indulekha99/Orthotic-Lowerlimb-Exoskeleton/README.md

# Orthotic-Lowerlimb-Exoskeleton
A lower limb exoskeleton for children capable of aiding the physical therapy process
