indulekha99/Orthotic-Lowerlimb-Exoskeleton/Report.pdf

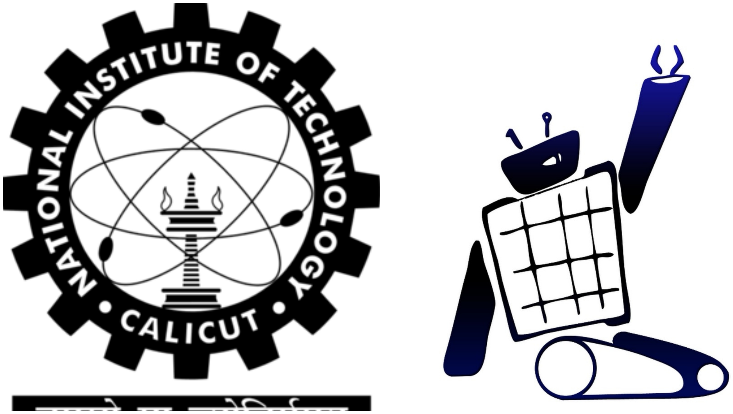
[picture p1: figure]

# REHABILITATION AND ASSISTIVE EXOSKELETON

## November 2021

## Contents

1 Introduction | 1
2 Gait Pattern | 2
3 Data Collection | 4
4 Mechanical Design | 7
5 Modelling | 13
6 Control | 20

## 1 Introduction

Exoskeletons are wearable robotic devices which are used for rehabilitation and for providing assistance in doing a task. It is powered by electric motors, pneumatics, hydraulics or combination of any of these to provide enhanced limb movement. Cerebral palsy is a neurological disorder that affects muscles of the patient and constrains him from doing any movements of his limbs easily. This motor neuron disease is a group of disorders that affect muscle movement and coordination. The best-known solution to this problem is physical therapy and regular walking practice. In the rehabilitation routine, the physiotherapist makes the patient perform certain gait cycles at varied speeds and distances. As repeating a task with negligible variation is a great challenge for humans, exoskeleton can be used to complete the task. This can also be used in places where strength is a key factor for work. It also empowers the military of the nation by making the job of the soldiers less tedious. Our aim is to build a lower limb exoskeleton for children capable of aiding the physical therapy process. Assistive exoskeletons are very expensive and cannot be purchased by a physiotherapy centre to provide treatment economically. With proper selection of actuators and other materials we can build it in a small budget.

## 2 Gait Pattern

A gait is a pattern of limb movements made during locomotion. Repetition of gait cycle leads to locomotion.

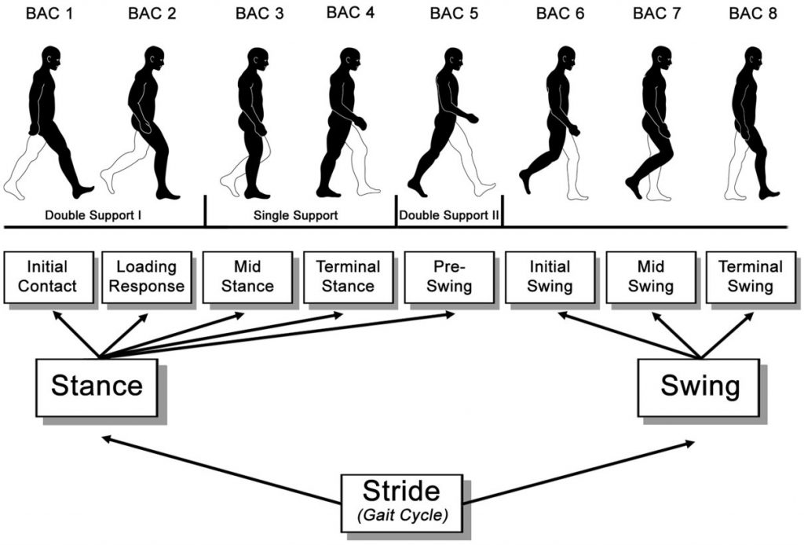
[picture p2: figure]

Figure 1: Gait Pattern

A complete gait cycle shown in the figure. For understanding we can define the gait cycle as the process between one foot striking the ground to the same foot again striking the ground. It is also known as one stride. The Gait cycle can be divided into two major phases:Stance phase, Swing phase

### 2.1 Stance phase

Stance phase is that part of a gait cycle during which the foot remains in contact with the ground. It constitutes almost 62
Initial Contact (Heel Strike): The heel of the reference foot touches the ground in front of the body.
Loading response : It begins immediately after the foot strike.During this phase body weight is transferred onto the supporting limb.
Mid-stance Phase: During mid-stance phase the reference foot contacts the ground flat-footed.
Terminal stance: Begins when the supporting heel rises from the ground and continues until the opposite heel touches the ground.
Pre-swing Phase: This phase corresponds to the loading response phase of the opposite foot.

### 2.2 Swing phase

Stance phase is that part of a gait cycle during which the reference foot is not in contact with the ground. It constitutes almost 38
Initial Swing Phase: The reference foot moves forward towards the opposite foot, while the knee and the hip are flexing.
Mid-swing Phase: Hip continues to flex, the reference foot pushes forward and gradually surpasses the supporting foot.
Terminal Swing Phase: During terminal swing phase, the reference foot begins landing to the ground as the respective knee and hip begin extension.

## 3 Data Collection

Lower limb rehabilitation assistive exoskeleton must have good human compatibility. Therefore the selection of actuators and links are the most essential parts of the design.Based on the torque provided by the actuator we need to choose it.Angular patterns can be obtained from a complete gait analysis of a healthy person.By which we can calculate torque acting on the joins. Gait analysis also provides foundation for the controlling part.
The human leg has 6 degrees of freedom (3DOF for hip, 1DOF for knee and 2DOF for ankle). The exoskeleton provides the actuation only in the sagittal plane there by restricting the degrees of freedom to 3. The orthotic lower limb device is an exoskeleton for hip and knee joints. Therefore, the data required for the analysis is the angular pattern of hip and knee joints. Different techniques used in the data acquisition process are
Use of Optical Rotary Encoders Use of IMUs (Inertial Measurement Units) Use of Imaging techniques

### 3.1 Optical Rotaty Encoder

An optical rotary encoder uses a reliable,defined pattern of light and dark to determine the position of the shaft and therefore the position of the link which is connected to the shaft. It converts the angular position or motion of a shaft or axle to analog or digital output signals.
In an optical rotary encoder there is a light source and sensor in between circular plates . It has continuous slots of equal width. The sensor has a phototransistor, resistor, and schmitt trigger. When light is passed through the slots phototransistor activates and it offers minimum(0) resistance, it is fed to the schmitt trigger and it produces low output and most of the voltage(5v) is dropped across the resistor. When light is blocked, the phototransistor will be in off stage and it offers maximum resistance.So nearly 5 v dropped across the phototransistor and nearly zero voltage dropped across the resistor. That 5 v fed to schmitt trigger and it gives maximum output. Square wave pattern is obtained.From this , number of pulses per unit time and corresponding angle of rotation can be calculated.
Encoder is placed at the hip and a link is connected to the shaft of the encoder then that link is attached to the thigh, from this encoder we can determine the angular pattern of the hip joint. Now another encoder is wielded to link whose other end is an encoder which is placed at the hip and a link is attached to the second encoder and that is attached to the shank, through this we can determine the angular pattern at the knee.

### 3.2 Inertial Measurement Unit

An Inertial Measurement Unit(IMU), is an electronic device that tracks rotational and translational movements. It is composed of 3 accelerometers, 3 gyroscopes, and depending on the heading requirement – 3 magnetometers.IMUs can measure a variety of factors, including speed, direction, acceleration, specific force, angular rate and magnetic fields surrounding the device (in the presence of a magnetometer).Each tool in an IMU is used to capture different data types: Accelerometer measures velocity and acceleration,Gyroscope measures rotation and rotational rate, Magnetometer establishes cardinal direction (directional heading)
Gyroscopes in general are devices that measure angular displacement ,angular velocity etc. Most gyroscopes only measure along a single sensitive axis.Therefore a combination of three orthogonally mounted gyroscopes is required to sense three dimensional angular motion.
This rotation about the spin axis is detected and information on this rotation is delivered to a motor or other device that applies torque in an opposite direction thereby canceling the precession and maintaining its orientation.
A plane portion is connected to the thigh and IMU is attached to it .The method of measuring angle is the same as that of encoder.

### 3.3 Imaging Techniques

With the development of photography and cinematography, it is possible to capture image sequences that reveal even minute details of human and animal locomotion. Three green colour circular stickers were attached. One is at the hip and the other is at knee and the other is at the ankle. By using image processing techniques in matlab we made everything black in the image except at the location of stickers. Now we have calculated the centroids of each sticker. By using those points in every frame we have calculated the angular pattern at the hip and knee.
Let ( X1, Y1) , ( X2, Y2) , ( X3, Y3) be the centroids of the markers at hip, knee and ankle joint respectively.
Tangent of the angular displacement of the thigh is given by

T an(θ) = Y2 − Y1
X2 − X1

(1)

So angular displacement of the thigh is

arctan

Y2 − Y1
X2 − X1

(2)

### 3.4 Data Obtained

The angular position of hip and knee joints are recorded using the above mentioned techniques as a function of time from a healthy human sample.The minimum and maximum torque for hip and knee joints are calculated.

Max value Min value

Angle in degrees | 14.57 | -18.12
Angle in radians | 0.25 | -0.31
Angular velocity | 1.4 | -2.53
Angular acceleration | 17.86 | -28.39

Table 1: Data of Hip from Image Processing

Max value Min value

Angle in degrees | 56.46 | -16.52
Angle in radians | 0.98 | 0.29
Angular velocity | 3.03 | -5.39
Angular acceleration | 64.37 | -56.28

Table 2: Data of Knee from Image Processing

Max value Min value

Angle in degrees | 22.85 | -8.56
Angle in radians | 0.4 | -0.15
Angular velocity | 2.7 | -1.3
Angular acceleration | 20 | -20

Table 3: Data of Hip from Encoder

Max value Min value

Angle in degrees | 11.5 | -68.5
Angle in radians | 0.2 | -1.2
Angular velocity | 6 | -10
Angular acceleration | 115 | -105

Table 4: Data of Knee from Encoder

Hip joint :
Maximum torque : 30Nm
Minimum torque in opposite direction: 25Nm Knee joint :
Maximum torque : 10Nm
Minimum torque in opposite direction : 7Nm
This data is used for the dynamic analysis of the human gait. By using methods like Lagrange and Newton-Euler formulation, the dynamic analysis of the gait is done to find the torque provided by the muscles for walking.The Newton-Euler formulation is derived by the direct interpretation of Newton’s Second Law of Motion, which describes dynamic systems in terms of force and momentum. In the Lagrangian formulation the system’s dynamic behavior is described in terms of work and energy using generalized coordinates.

## 4 Mechanical Design

The exoskeleton design consists of 10 degrees of freedom(DOF) out of which 4 are active and 6 are passive. The 4 active DOF s are 2 knee joints and 2 hip joints which are revolute joints about mediolateral axis( axis perpendicular to the sagittal plane) and are controlled by DC motors. One DOF for each ankle joint(about a mediolateral axis), one DOF for each hip about an axis parallel to the anterior-posterior axis( the axis perpendicular to the frontal plane) and 2 DOF at the back of the exoskeleton about an axis parallel to the anterior-posterior axis are the 6 passive DOFs.

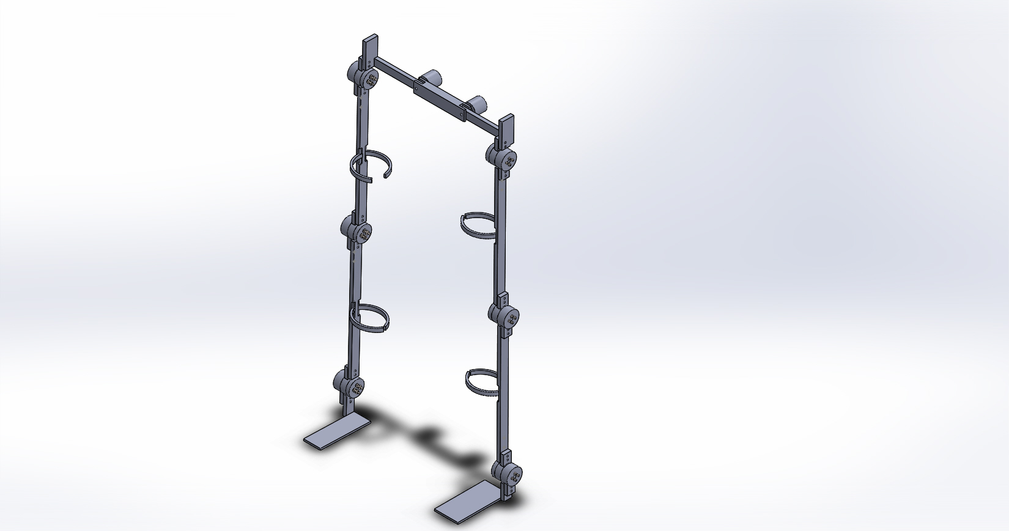
[picture p3: figure]

Figure 2: Lowerlimb Exoskeleton

Different Parts of the Design:-
1.There are 4 links that give structure to the exoskeleton and supports the human body. They are directly attached to the legs. Actuations are transmitted to the legs through these links
2.There are 4 joints through which the load is transmitted, out of which two joints are active and act as active joints. The joints should be able to transmit the load properly and at the same time, they should provide smooth movement to the limbs. Joint consist of 3 parts,
a) Middle Part This is the part that encloses a ball bearing and it connects to one of the links at the joint.
b) Outer Part The outer part connects to the adjacent link. It has a projection that goes halfway through the inner cylindrical portion of the ball bearing. The outer portion has a hole for the attachment of the motor shaft. In addition to this hole outer part have 4 holes for fastening with nuts and bolts.
c) Inner Part The Inner part is similar to the outer part except that it does not have a hole for motor shaft attachment.
Middle Part and Outer part fits inside the ball bearing from opposite sides and are fastened by 4 nuts and bolts. Middle Part connects the joint to one link and the Outer Part connects to the adjacent link. This type of arrangement ensures that

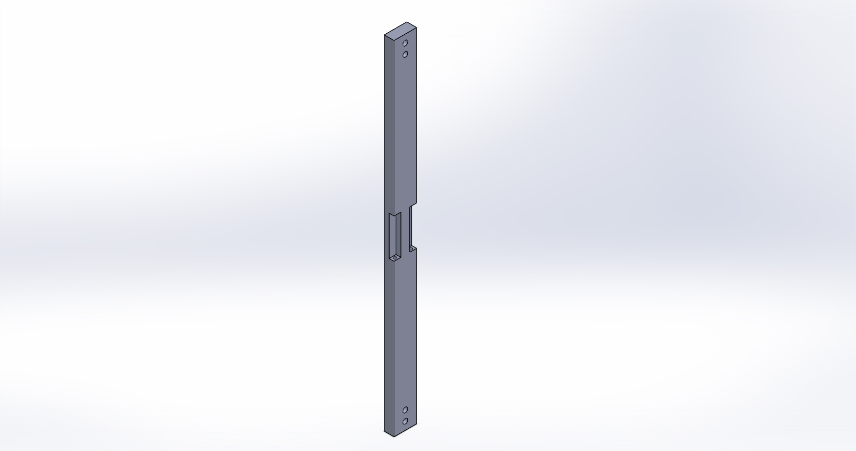
[picture p4: figure]

Figure 3: Link

the joint transmits the load without any failure and the relative movement between the links are smooth.
3.Hip Assembly Hip Assembly consists of 3 links and has two passive DOFs where two encoders are attached for data collection. Hip Assembly is directly attached to the body and is connected to the thigh link through 2 active joints and 2 passive joints.

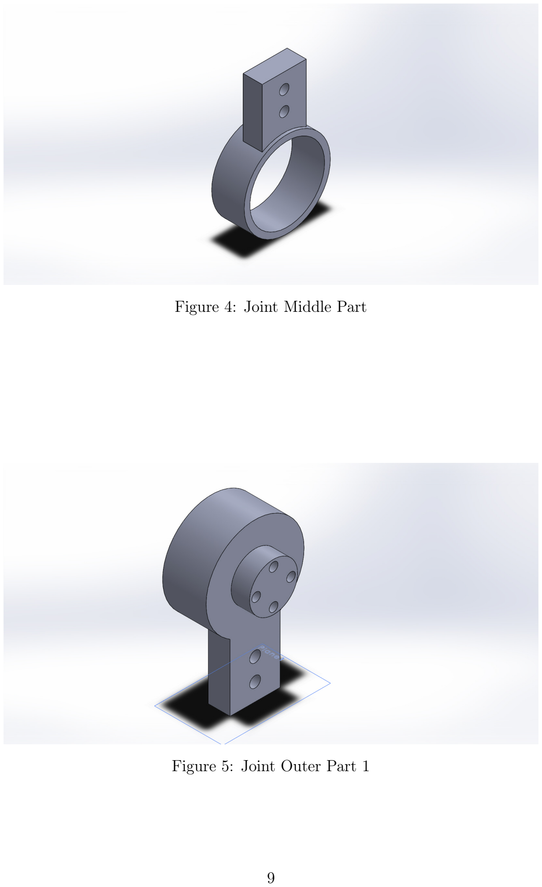
[picture p5: page 11]

Figure 4: Joint Middle Part

Figure 5: Joint Outer Part 1

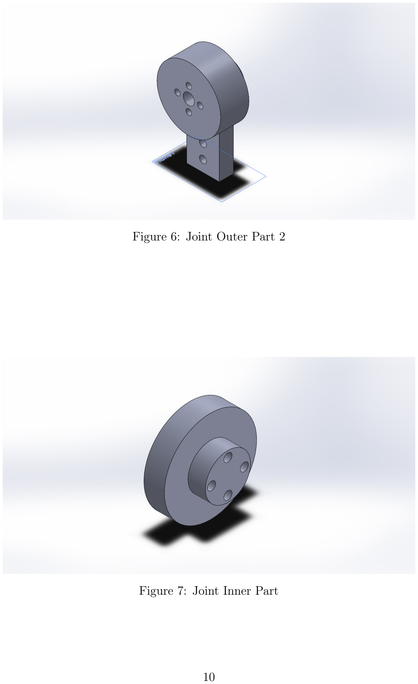
[picture p6: page 12]

Figure 6: Joint Outer Part 2

Figure 7: Joint Inner Part

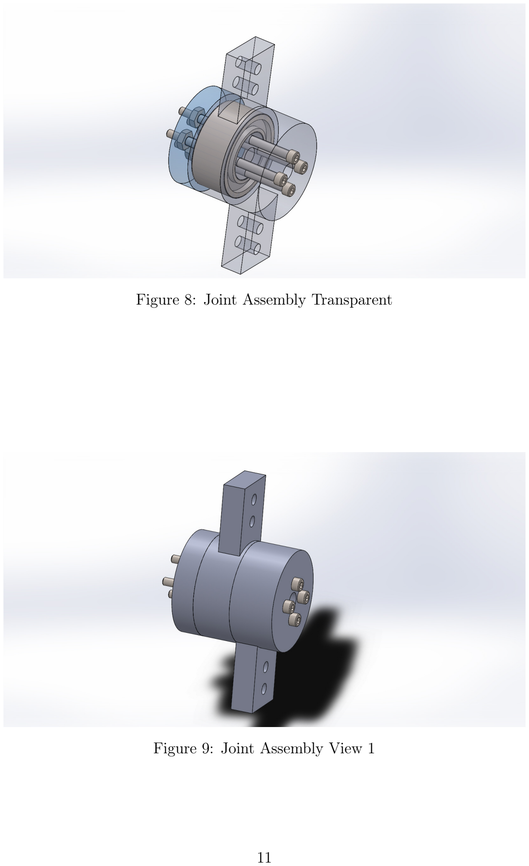
[picture p7: page 13]

Figure 8: Joint Assembly Transparent

Figure 9: Joint Assembly View 1

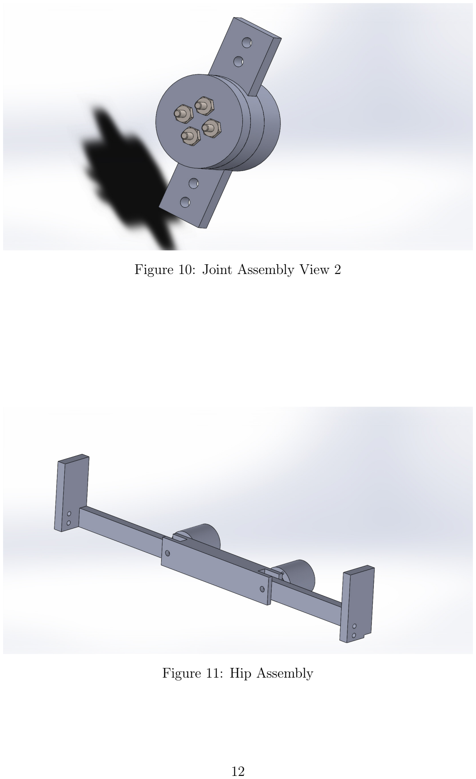
[picture p8: page 14]

Figure 10: Joint Assembly View 2

Figure 11: Hip Assembly

## 5 Modelling

### 5.1 Static Analysis

### 5.1.1 Forward kinematics

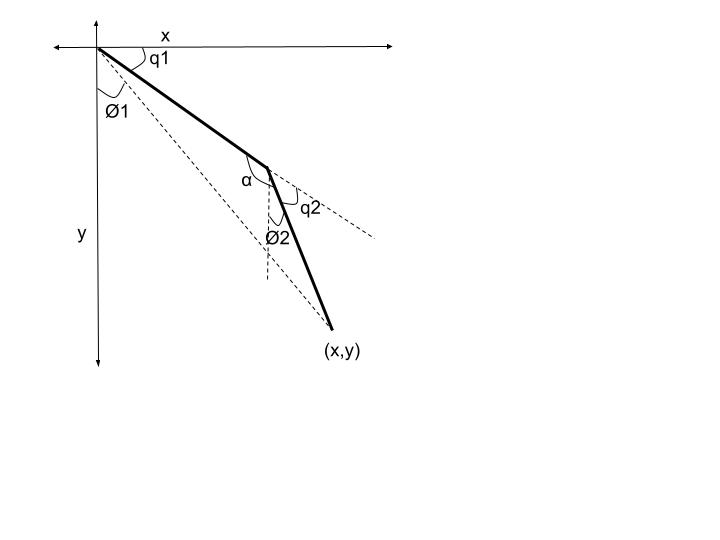
[picture p9: figure]

Figure 12: Forward Kinematics

We are dealing with the motion of the lower limb in the sagittal plane. Therefore constraining the motion in a 2D plane.
Length of link 1 = L1
Length of link 2 = L2
Angle made by link 1 = q1
Angle made by link 2 = q2
Task space, X = [x,y]
Joint/control space, q = [q1, q2]
End-effector:

X = F(θ) = [x, y] = [L1cos(q1) + L2cos(q1 + q2), L1sin(q1) + L2sin(q1 + q2)] (3)

### 5.1.2 Inverse kinematics

Consider the triangle AOB shown in the figure (13). AB = R = p
x

2 + y

2
Angle AOB = α
Apply cosine law We get

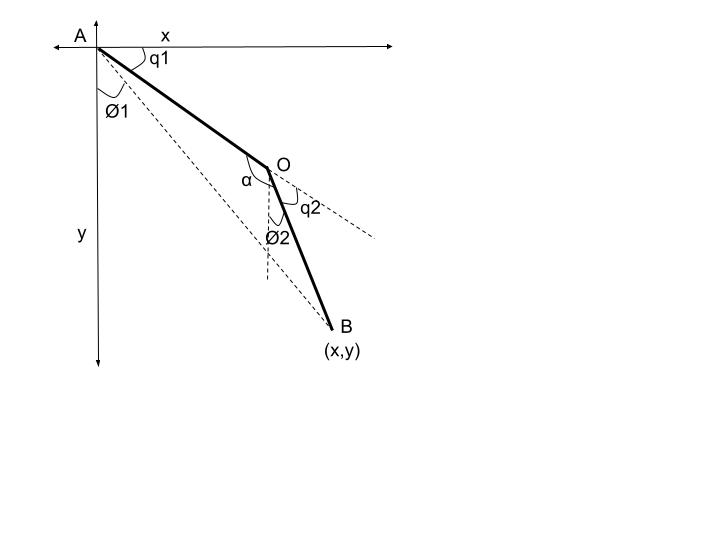
[picture p10: figure]

Figure 13: Inverse Kinematics

R

2 = L

2
1 + L

2
2 − 2L1L2cos(α) | (4)

cos(α) = L

2
1 + L

2

2 − X² − Y

2
2L1L2

(5)

q2 = π − α
cos(q2) = −cos(α)
cos(q2) = X² + Y

2 − L

2
1 − L

2
2
2L1L2

(6)

q2 = arccos

X² + Y

2 − L

2
1 − L

2
2
2L1L2

(7)

In triangle OBC in figure (14)

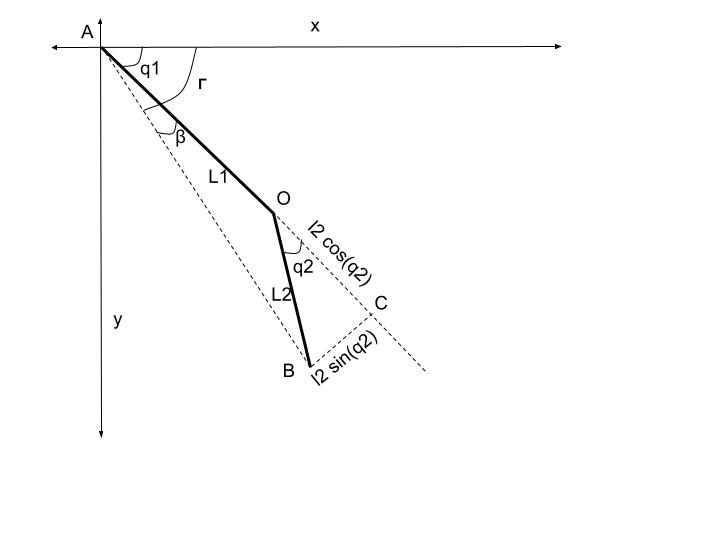
[picture p11: figure]

Figure 14: Inverse Kinematics

OC = L2cos(q2)
BC = L2sin(q2)
tan(β) = BC
AC
tan(β) = | L2sin(q2)
| L1 + L2cos(q2)

(8)

γ = q1 + β = arctan

y
x

(9)

q1 = arctan

| y
| x − arctan

L2sin(q2)
L1 + L2cos(q2)

(10)

From the equation 10 it is clear that q1 also depended on q2.
For a 2D two link manipulator there can be two solutions for q1 and q2. When we solve for q2
We get

cos(q2) = X

2 + Y

2 − L

2
1 −

L

2
2
2L1L2

(11)

w.k.t cos (q2) = cos(−q2)
So there is another pair of angles (q1, q2) which give the same end effector (x,y).

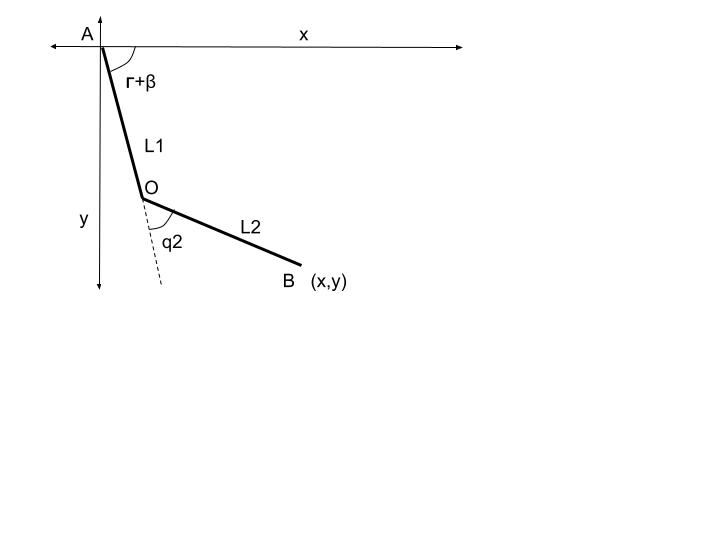
[picture p12: figure]

Figure 15: Inverse Kinematics

q2 = −X

2 + Y

2 − L

2
1 −

L

2
2
2L1L2

(12)

When we put -q2 in the equation 10

q1 = γ + β = arctan

y
x

+ arctan

L2sinq2
L1 + L2cos(q2)

(13)

But in our case this solution is not possible. Because the knee can only bend backwards.
We are dealing with hip ϕ1 and knee angle ϕ1 , that we can obtain from q2 and q2

ϕ1 = (π
2
− q1) | (14)
ϕ2 = (π
2
− (q1 + q2)) | (15)

### 5.2 Dynamic Analysis

Consider the 2 links of the exoskeleton as shown in figure (16). Masses of link 1 and 2 are m1 and m2 respectively. X axis is considered as the reference for gravitational potential energy(PE=0).

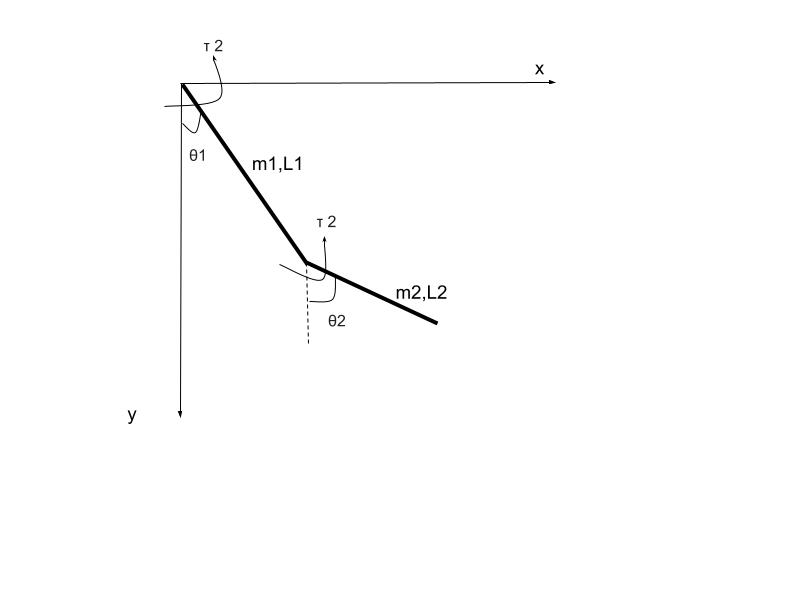
[picture p13: figure]

Figure 16: Dynamic Analysis

For Link 1, consider an element of length dl at a distance of l from the ori-gin,position and velocity of that element is

x1 = lsin(θ1) | (16)
y1 = lcos(θ1) | (17)

x˙1 = l

˙θ1cos(θ1) | (18)

y˙1 = −l

˙θ1sin(θ1) | (19)
| (20)

Now the kinetic energy can be expressed as ,

KE =

1
2

mv²

=

1
2

m( ˙x

2 + ˙y

2
) | (21)

The mass per unit length of link 1 is, is mi = m1/L1. Now the kinetic energy of the elemental mass of length dl is

dKEi =

1
2

(mi ∗ dl)( ˙x1

2 + ˙y1

2
)

=

1
2

mi( ˙x1

2 + ˙y1

2
)dl

=

1
2

mi((l

˙θ1cos(θ1))² + (−l

˙θ1sin(θ1))²
)dl

=

1
2

mi

l

2 ˙θ1

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
2 ˙θ1

2
dl | (22)

The total kinetic energy of link 1 can be obtained by integrating (22) along its length , ie from 0 to L1.

KE1 =

Z L1

0

1
2

m1
L1

l

2 ˙θ1

2
dl

=

1
6

m1L

2/1˙θ1

2
(23)

The potential energy of link 1 with centre of mass at (xcom1, ycom1) is,

P E1 = m1gycom1

P E1 = −m1g

L1
2
cos(θ1) | (24)

To get KE and PE for link 2 , consider an element of length dl at a distance of l from the starting of link 2,position and velocity of that element is

x2 = L1sin(θ1) + lsin(θ2) | (25)
y2 = L1cos(θ1) + lcos(θ2) | (26)

x˙2 = L1

˙θ1cos(θ1) + l

˙θ2cos(θ2) | (27)

y˙2 = −L1

˙θ1sin(θ1) − l

˙θ2sin(θ2) | (28)

KE of the elemental mass is,

dKE2 =

1
2

(mi ∗ dl)( ˙x2

2 + ˙y2

2
)

=

1
2

m2
L2

( ˙x2

2 + ˙y2

2
)dl

=

1
2

m2
L2

[(L1

˙θ1cos(θ1) + l

˙θ2cos(θ2))² + (−L1

˙θ1sin(θ1) − l

˙θ2sin(θ2))²
| ]dl (29)

Integrating (29) along the length of link 2 gives the total kinetic energy of link 2 as,

KE2 =

Z L2

0

[

1
2

m2
L2

[(L1

˙θ1cos(θ1) + L2

˙θ2cos(θ2))² + (−L1

˙θ1sin(θ1) − L2 | ˙θ2sin(θ2))²
]] dl

=

1
2

m2(L

2/1˙θ1

2
+

L

2/2˙θ2

2

3

+ L1L2

˙θ1

˙θ2cos(θ1 − θ2)) | (30)

The potential energy of link 2 with centre of mass at (xcom2, ycom2) is,

P E2 = m2gycom2
P E2 = −m2g(L1cos(θ1) + L2 2
cos(θ2)) | (31)

The Lagrangian of the system is,

L = KE − P E | (32)
= (KE1 + KE2) − (P E1 + P E2)

=

1
6

M1L

2/1˙θ1

2
+

1
2

M2[L

2/1˙θ1

2
+

L

2/2˙θ2

2

3

+ L1L2

˙θ1
˙θ2cos(θ1 − θ2)]

+ m1g

L1
2

cos(θ1) + m2g[L1cos(θ1) + L2 2

cos(θ2)] | (33)

The Lagrangian equations for two generalised coordinates θ1 and θ2 with non-conservative torques τ1 and τ2 acting as shown in Figure 16 are ,
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
= τ1 | (34)

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
= τ2 | (35)

Each term for (34) and (35) is obtained from the Lagrangian of the system (33) as, ∂L
∂

˙θ1

=

1
3

m1L

2/1˙θ1 +

1
2

m2[2L

2/1˙θ1 + L1L2

˙θ2cos(θ1 − θ2)] | (36)

d
dt(

∂L
∂

˙θ1

) = 1
3

m1L

2/1¨θ1 +

1
2

m2[2L

2/1¨θ1 + L1L2(

¨θ2cos(θ1 − θ2) − ˙θ2sin(θ1 − θ2)( ˙θ1 − ˙θ2))]

(37)
∂L
∂θ1

= −

1
2

m2L1L2

˙θ1

˙θ2sin(θ1 − θ2) − m1g

L1
2
sin(θ1) − m2gL1sin(θ1) | (38)

Substituting above 2 into (34) gives,

τ1 =

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
= ¨θ1[

1
3

m1L

2
1 + m2L

2/1] + ¨θ2

1
2

m2L1L2cos(θ1 − θ2)

+ ˙θ2

2 1
2

m2sin(θ1 − θ2)L1L2 + L1g(

m1
2
+ m2)sin(θ1) | (39)

Similarly for generalised coordinate θ2,

τ2 =

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
2/2¨θ2 + L1L2
˙θ1cos(θ1 − θ2) − L1L2
˙θ1sin(θ1 − θ2)( ˙θ1 − ˙θ2)]

−

1
2

m2L1L2

˙θ1

˙θ2sin(θ1 − θ2) + m2g

L2
2
sin(θ2) | (40)

Equations (39) and (40) represents the governing dynamical equations of 2 link model with torques τ1 and τ2 acting as shown in Figure 16.

## 6 Control

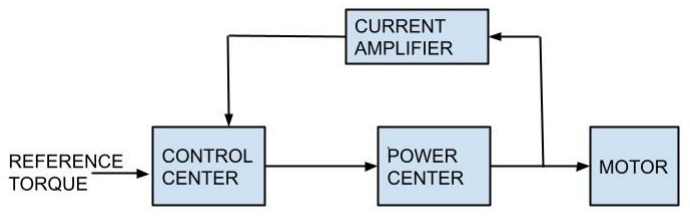
[picture p14: figure]

Figure 17: Control System Block Diagram

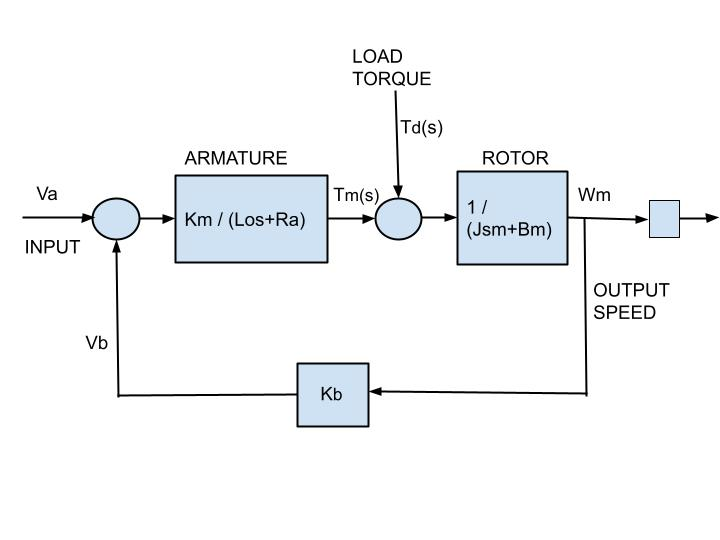
[picture p15: figure]

Figure 18: Motor Block Diagram

The main objective of the exoskeleton is to help in rehabilitation of the cerebral palsy affected kids. In the rehabilitation process, the patient is to be trained for two different parameters of gait. They are the step length and the speed of walking. The control system is robustly designed in order to accommodate these different parameters. The control module takes in as input the step length and the speed to generate a suitable gait pattern and precisely control the movements of each joint for a coordinated movement.
In order to coordinate the joint motion, a co-relation between the joint angle of each joint with respect to other joints is found. Having the coordinated joint angles, the controller achieves precise movement of each joint using a feedback control system to reduce the error. The speed on the joints is controlled by regulating the voltage which there by controls the angular velocity of each joint which in turn controls the speed of walking.
DC motor is a device which converts electrical energy (Direct Current) to mechanical work.It works on the principle “ current carrying conductor placed in a magnetic field experiences mechanical force” and “Faraday’s law of electromagnetic Induction (Lorentz;s law)”.
It is widely used in industry due to its high torque and excellent speed control compatibility.
Applied voltage, Ea
Back e.m.f, Eb
Armature current, Ia
Impedance offered by armature, La + Ra Apply KVL in loop
We get,

Ea = Eb + (IaRa + L

dIa
dt ) | (41)

Eb =

(P nϕw)
60A

(42)

Here P is the number of poles, n is the number of coils, A is a constant and is the magnetic flux.In today’s DC motors, electromagnets are used. As a result, by having a fixed amount of current to the electromagnet, we can create a fixed amount of flux.Therefore a particular DC motor all the above things mentioned are constants.So equation can be rewritten as

Eb = Kbw | (43)

where w is the speed of the motor. Substituting equation 41 in equation 43

W =

(Ea − (IaRa + L

dIa
dt ))
Kb

(44)

Which indicates DC motor speed can be varied by changing armature voltage or supply voltage.
Torque vs Current relation in a motor Torque,
τm = F.d | (45)
F = B.Ic.L | (46)

Where
B is flux density
Ic is current through Coil L is length of the coil

Ic =

Ia
A

(47)

τm =

B.Ia.L
A
d | (48)

=

ϕLd
A²
Ia | (49)
= KmIa | (50)

Going back to equation 41

Ea = Eb + (IaRa + L

dIa
dt ) | (51)

Converting it to laplace domain

Ea(s) − Eb(s) = (Ra + LaS)Ia(s) | (52)
Ia(s) = Ea(s) − Eb(s)
(Ra + LaS)

(53)

Tl(s) = Tm(s) − Td(s) | (54)

Motor output torque equation

Im

dw
dt = τm − τl − BmWm | (55)

Im is inertia of rotor
Bm is viscous damping
In laplace domain
τm − τl = Wm(Bm + ImS) | (56)

Wm =

τm − τl
(Bm + ImS)

(57)

From above expression we get transfer function of DC motor is

Wm(s)
Ea(s)

=

Km
(Ra + LaS) + (Bm + ImS + KmKb)

(58)
