indulekha99/Orthotic-Lowerlimb-Exoskeleton/CAD Model/Assembly4.SLDASM

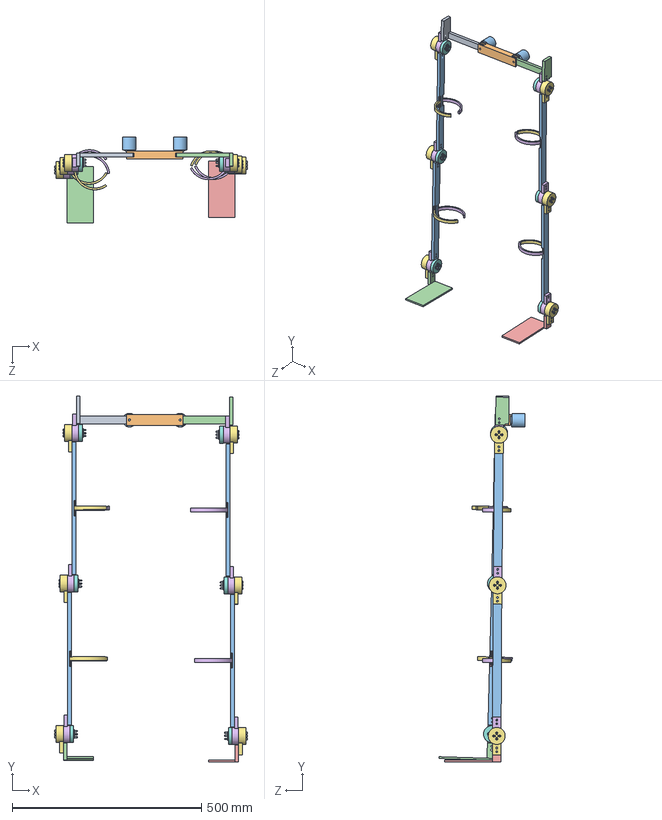
[picture p16: CAD file, 2022-07-30]
CAD Model/Assembly4.SLDASM
510.5 x 967.4 x 228.2 mm
link_1
link_2
enc2 x 2
link_1.2
feet
jointPart1 x 6
joint outer1 x 6
socket head cap screw_ai x 24
machine screw nut hex_ai x 24
thigh12 x 4
feet2
attachShaft x 8
clamp1 x 4
clamp2 x 4
