indulekha99/Orthotic-Lowerlimb-Exoskeleton/CAD Model/new assembly.SLDASM

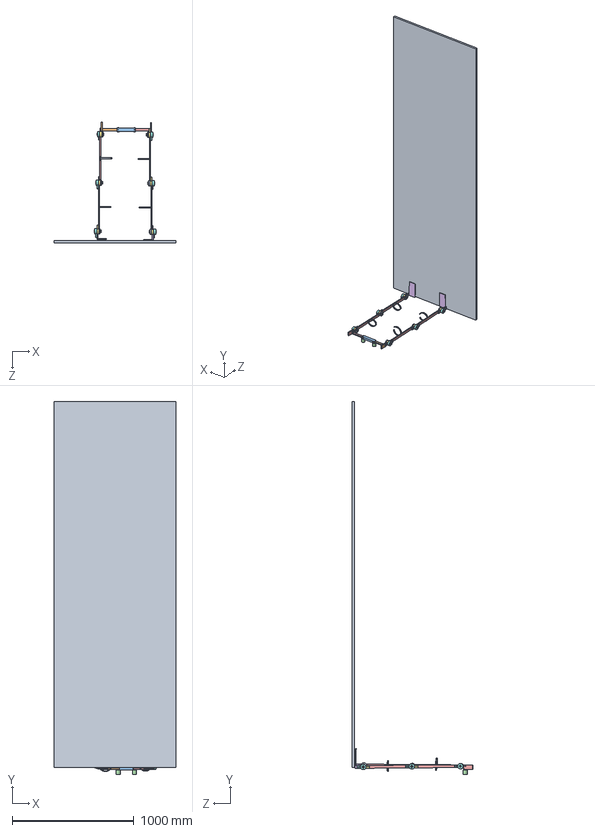
[picture p17: CAD file, 2022-07-30]
CAD Model/new assembly.SLDASM
1000.0 x 3057.7 x 989.2 mm
ground
link_1
link_2
enc2 x 2
link_1.2
feet
jointPart1 x 6
joint outer1 x 6
single row cylindrical roller bearing_is x 6
socket head cap screw_ai x 24
machine screw nut hex_ai x 24
thigh12 x 4
feet2
attachShaft x 8
clamp1 x 4
clamp2 x 4
