indulekha99/Orthotic-Lowerlimb-Exoskeleton/CAD Model/hip_assem.SLDASM

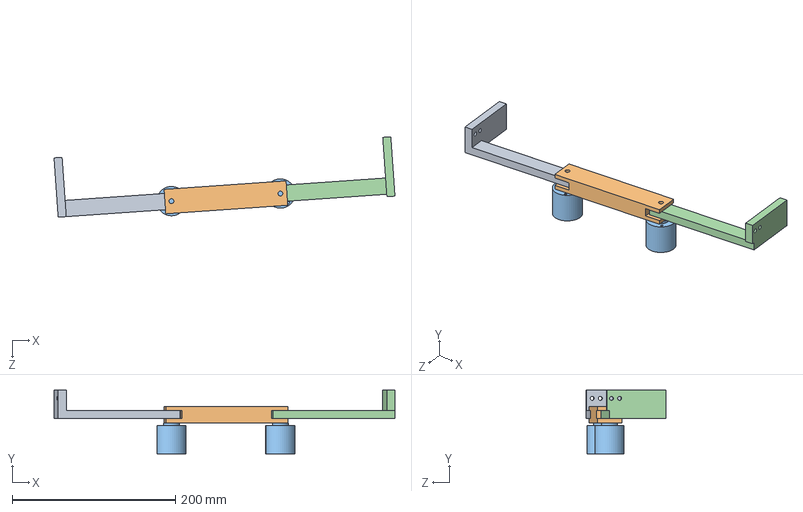
[picture p18: CAD file, 2022-07-30]
CAD Model/hip_assem.SLDASM
418.3 x 78.0 x 98.7 mm
link_1
link_2
enc2 x 2
link_1.2
