indulekha99/Orthotic-Lowerlimb-Exoskeleton/CAD Model/JointAssem1.SLDASM

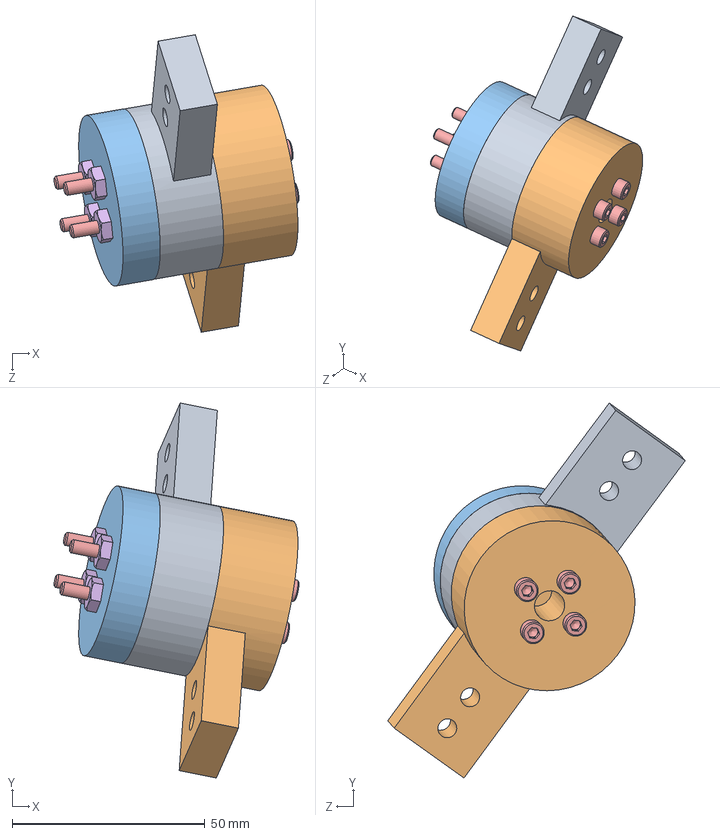
[picture p19: CAD file, 2022-07-30]
CAD Model/JointAssem1.SLDASM
63.6 x 97.4 x 77.3 mm
jointPart1
joint outer1
single row cylindrical roller bearing_is
socket head cap screw_ai x 4
machine screw nut hex_ai x 4
