indulekha99/Orthotic-Lowerlimb-Exoskeleton/CAD Model/clamp1.SLDPRT

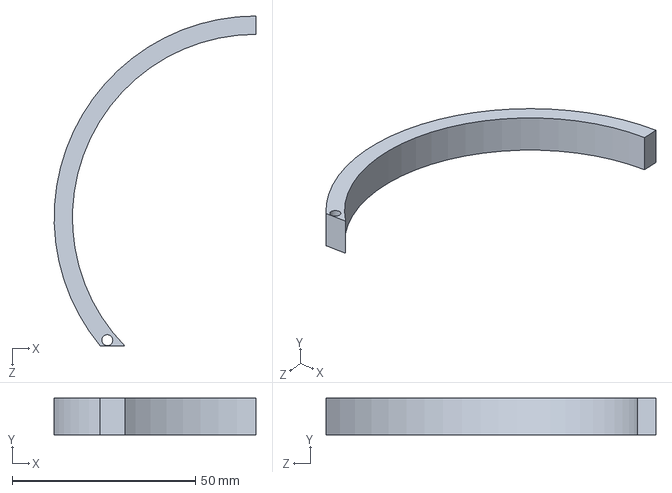
[picture p20: CAD file, 2022-07-30]
CAD Model/clamp1.SLDPRT
55.0 x 10.0 x 90.0 mm
