indulekha99/Orthotic-Lowerlimb-Exoskeleton/CAD Model/link_1.SLDPRT

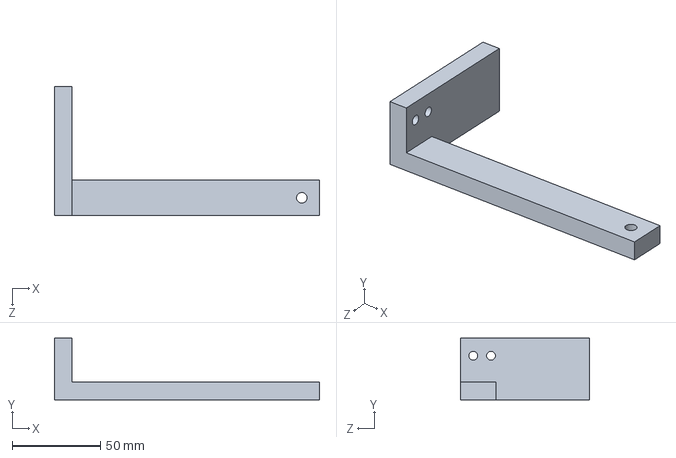
[picture p21: CAD file, 2022-07-30]
CAD Model/link_1.SLDPRT
150.0 x 35.0 x 73.0 mm
