indulekha99/Orthotic-Lowerlimb-Exoskeleton/CAD Model/joint outer1.SLDPRT

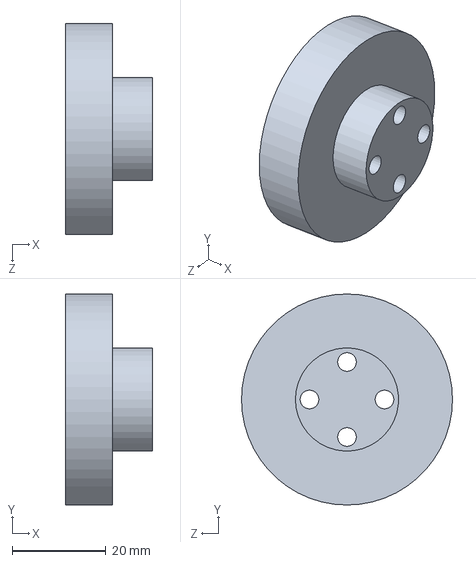
[picture p22: CAD file, 2022-07-30]
CAD Model/joint outer1.SLDPRT
18.5 x 45.0 x 45.0 mm
