indulekha99/Orthotic-Lowerlimb-Exoskeleton/CAD Model/link_2.SLDPRT

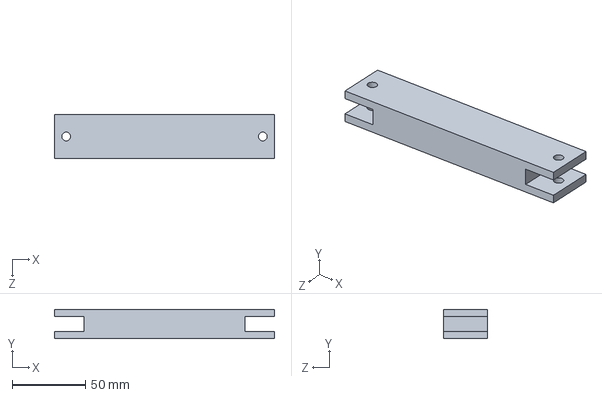
[picture p23: CAD file, 2022-07-30]
CAD Model/link_2.SLDPRT
150.0 x 20.0 x 30.0 mm
