indulekha99/Orthotic-Lowerlimb-Exoskeleton/CAD Model/feet2.SLDPRT

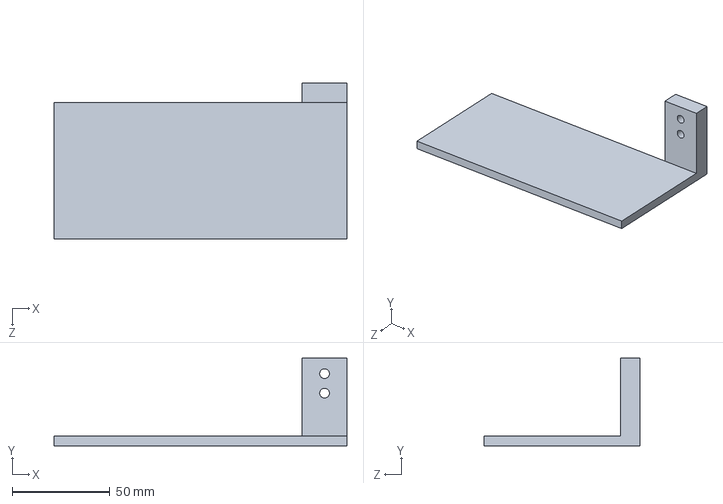
[picture p24: CAD file, 2022-07-30]
CAD Model/feet2.SLDPRT
150.0 x 45.0 x 80.0 mm
