indulekha99/Orthotic-Lowerlimb-Exoskeleton/CAD Model/jointPart1.SLDPRT

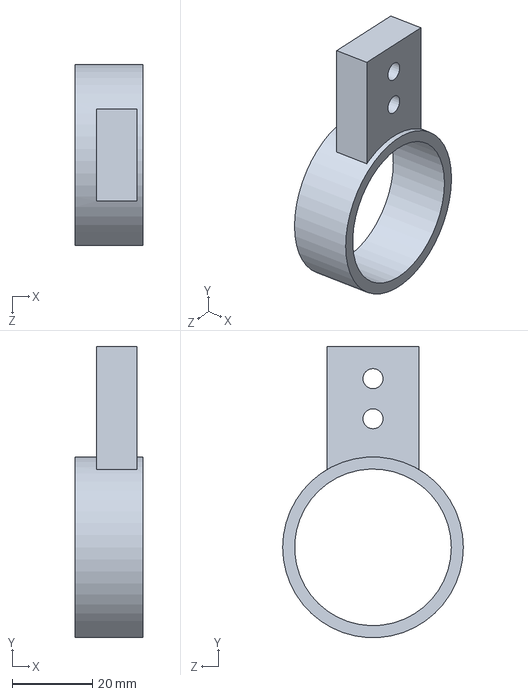
[picture p25: CAD file, 2022-07-30]
CAD Model/jointPart1.SLDPRT
17.0 x 72.4 x 45.0 mm
