indulekha99/Orthotic-Lowerlimb-Exoskeleton/CAD Model/Part3.SLDPRT

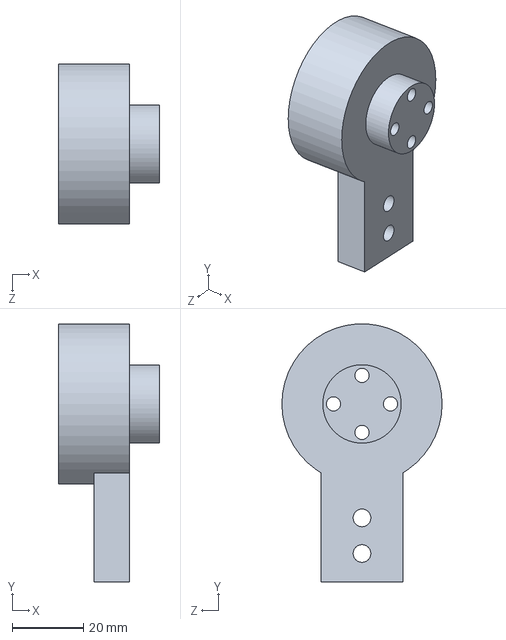
[picture p26: CAD file, 2022-07-30]
CAD Model/Part3.SLDPRT
28.5 x 72.4 x 45.0 mm
