indulekha99/Orthotic-Lowerlimb-Exoskeleton/CAD Model/thigh12.SLDPRT

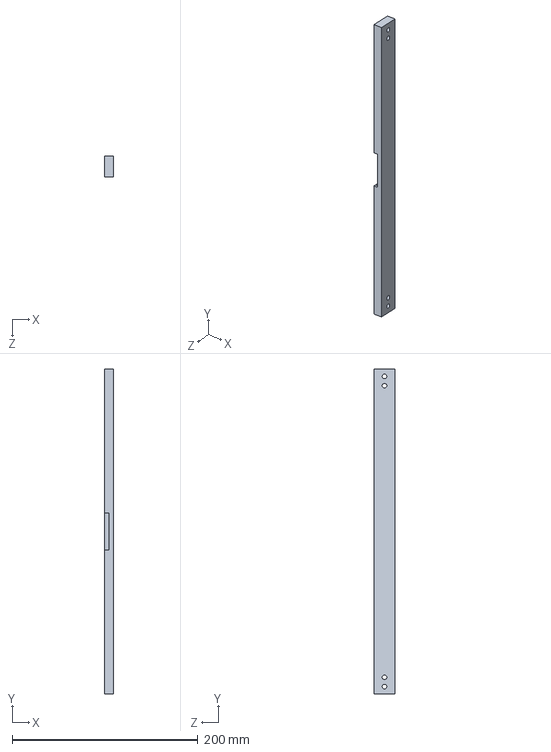
[picture p27: CAD file, 2022-07-30]
CAD Model/thigh12.SLDPRT
10.0 x 350.0 x 23.0 mm
