indulekha99/Orthotic-Lowerlimb-Exoskeleton/CAD Model/enc2.SLDPRT

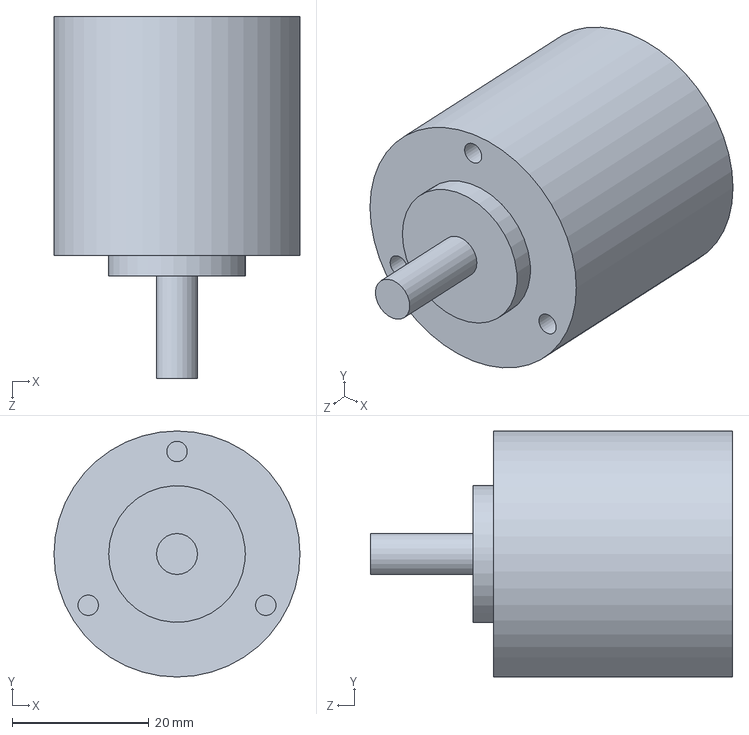
[picture p28: CAD file, 2022-07-30]
CAD Model/enc2.SLDPRT
36.0 x 36.0 x 53.0 mm
