indulekha99/Orthotic-Lowerlimb-Exoskeleton/CAD Model/attachShaft.SLDPRT

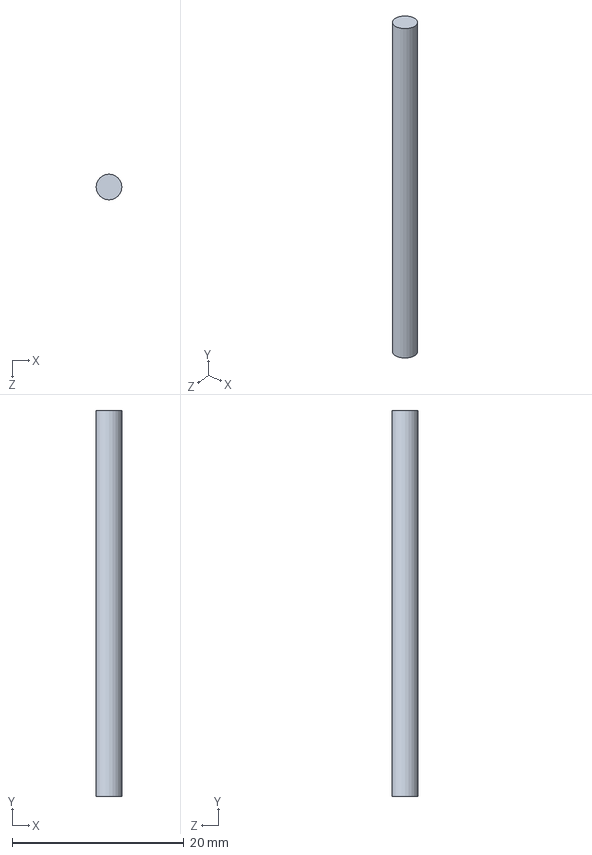
[picture p29: CAD file, 2022-07-30]
CAD Model/attachShaft.SLDPRT
3.00 x 45.0 x 3.00 mm
