indulekha99/Orthotic-Lowerlimb-Exoskeleton/(list of files, cad)

Other CAD files:
CAD Model/link_1.2.SLDPRT
CAD Model/feet.SLDPRT
CAD Model/clamp2.SLDPRT
CAD Model/Assembly4.x_t
CAD Model/new assembly.x_t
